okayjustin/ee541/Software/sar_image.png

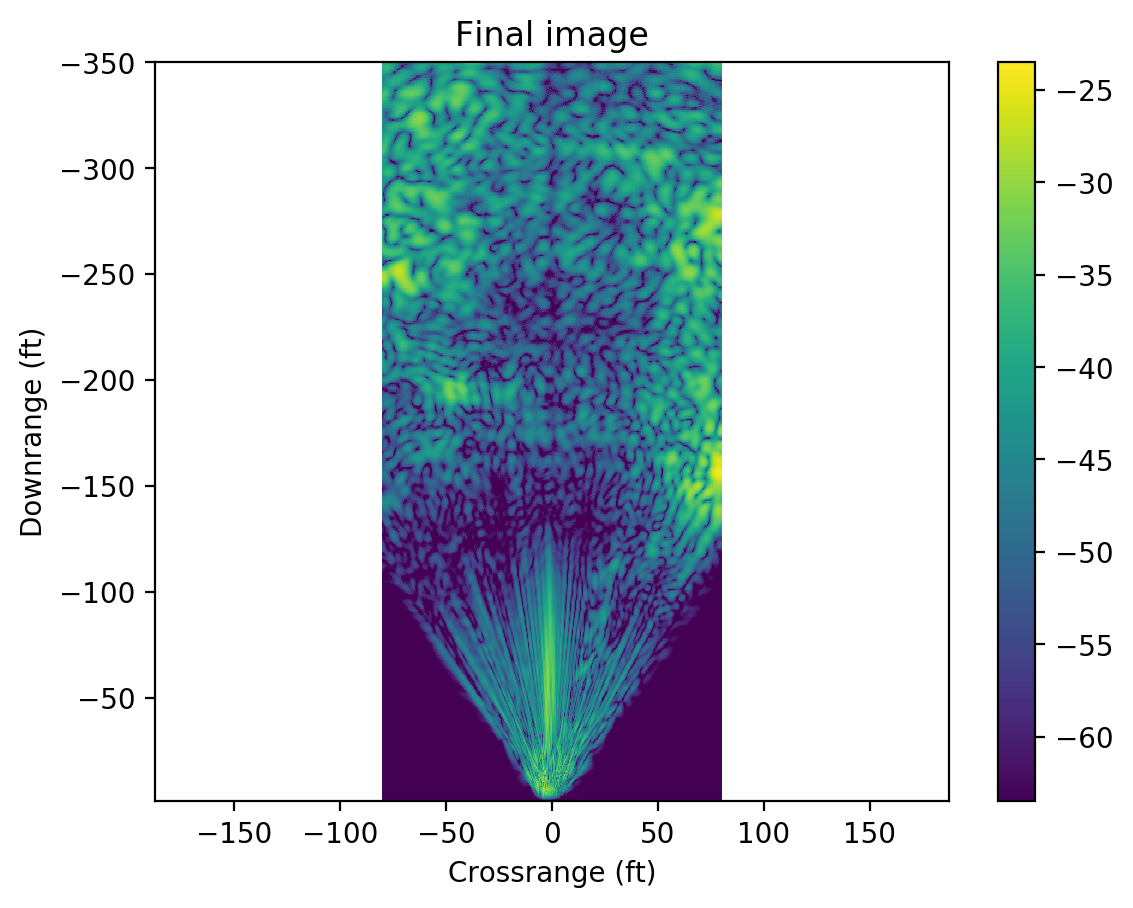
Software/sar_image.png
