okayjustin/ee541/Mechanical/assem.SLDASM

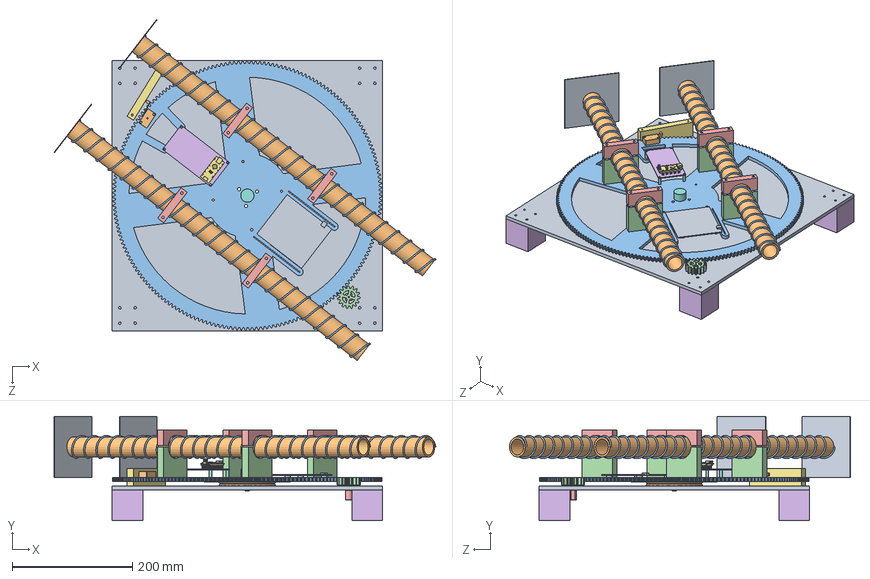
[picture p2: CAD file, 2017-03-17]
Mechanical/assem.SLDASM
635.3 x 173.2 x 567.3 mm
base_board
turntable
motor_shaft
pinion
motor_body
leg x 4
switch_trig_block
slipring
copper clad board x 2
pvc x 2
spiral coil x 2
antenna_holder_bottom x 4
antenna_holder_top x 4
PCB
Arduino Nano
nylon spacer x 4
vco_board
microswitch
table_gear_smaller
