okayjustin/ee541/Mechanical/table_assem.SLDASM

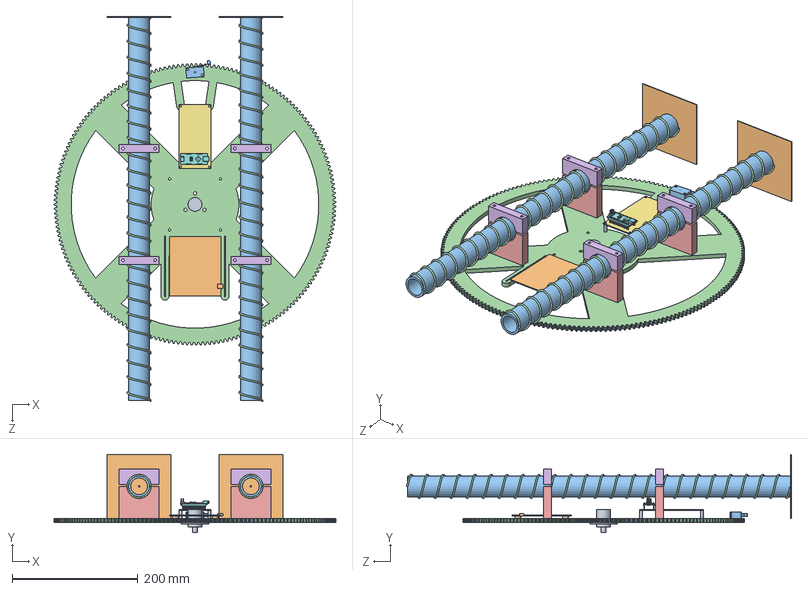
[picture p3: CAD file, 2017-03-17]
Mechanical/table_assem.SLDASM
447.9 x 124.3 x 612.2 mm
slipring
copper clad board x 2
pvc x 2
spiral coil x 2
antenna_holder_bottom x 4
antenna_holder_top x 4
PCB
Arduino Nano
nylon spacer x 4
vco_board
microswitch
table_gear_smaller
