okayjustin/ee541/Mechanical/antenna.SLDASM

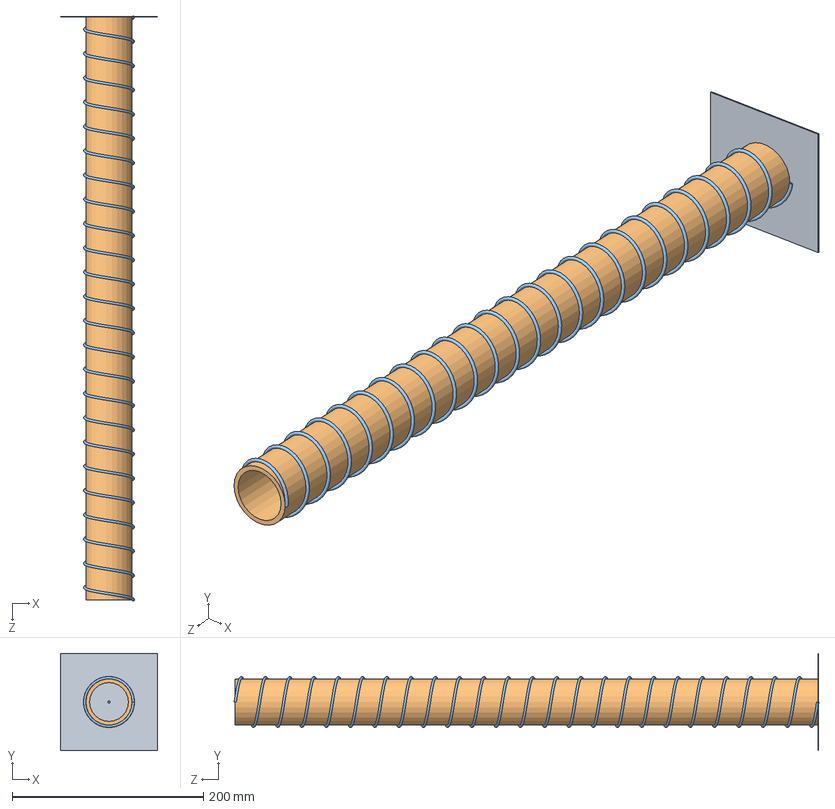
[picture p4: CAD file, 2017-03-11]
Mechanical/antenna.SLDASM
101.6 x 101.6 x 612.2 mm
copper clad board
pvc
spiral coil
