okayjustin/ee541/Mechanical/pinion_shaft_assem.SLDASM

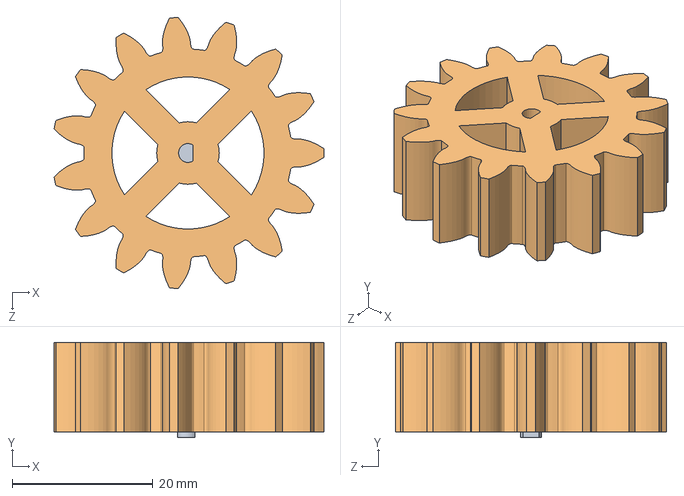
[picture p5: CAD file, 2017-03-11]
Mechanical/pinion_shaft_assem.SLDASM
38.3 x 13.5 x 38.6 mm
motor_shaft
pinion
