okayjustin/ee541/Mechanical/geartest.SLDASM

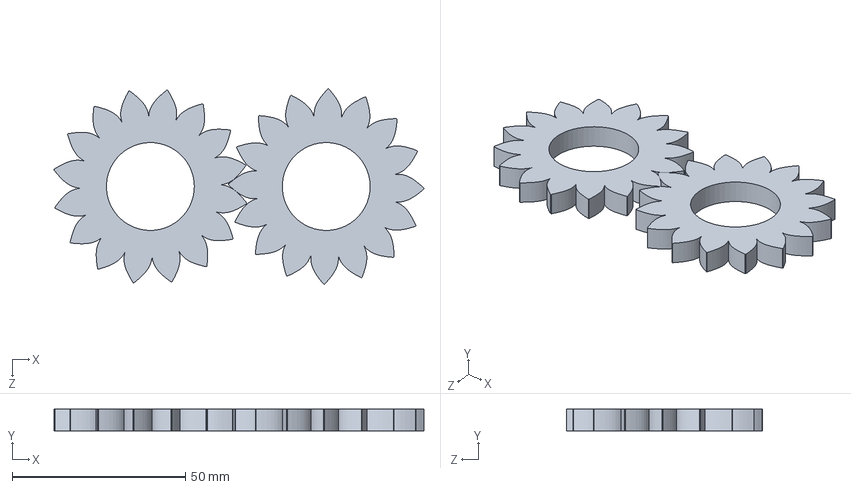
[picture p6: CAD file, 2017-02-28]
Mechanical/geartest.SLDASM
106.9 x 6.35 x 56.5 mm
spur_gear x 2
