okayjustin/ee541/Mechanical/table_gear.SLDPRT

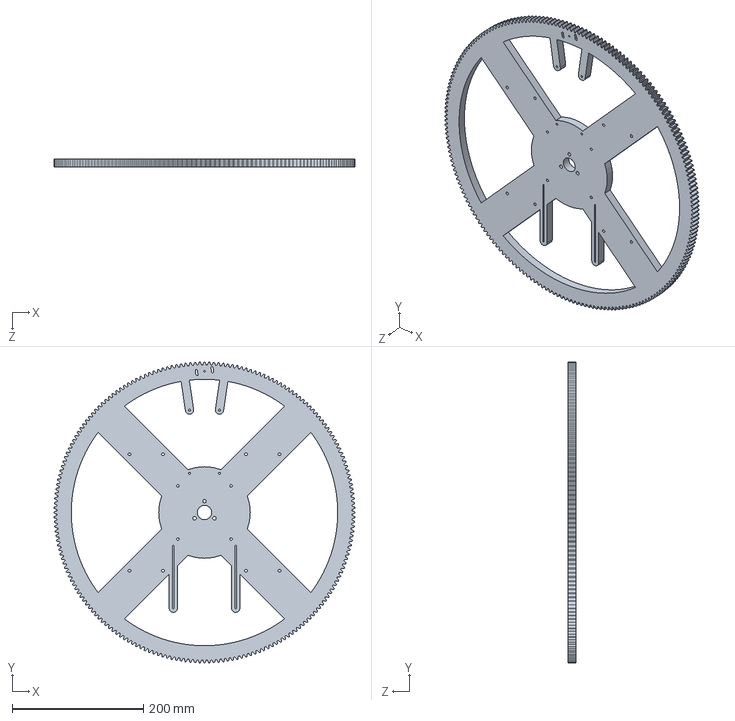
[picture p7: CAD file, 2017-03-17]
Mechanical/table_gear.SLDPRT
459.3 x 459.3 x 12.7 mm
