okayjustin/ee541/Mechanical/base_board.SLDPRT

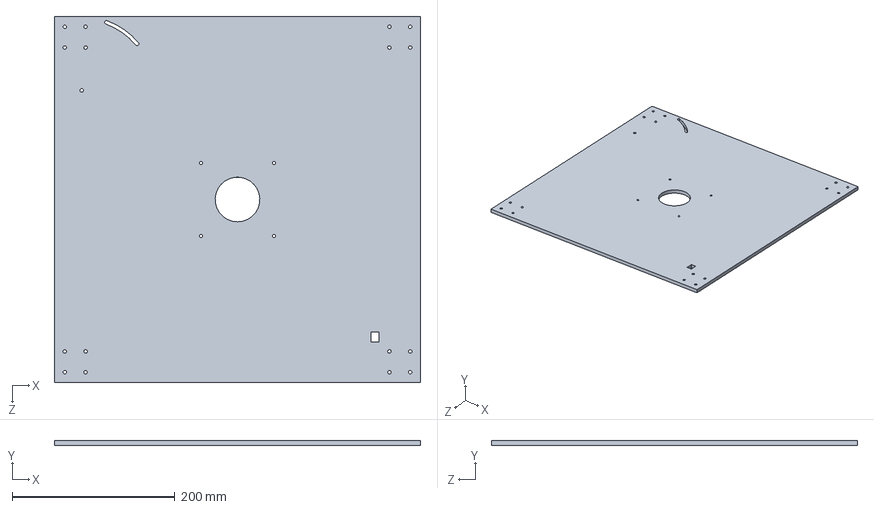
[picture p8: CAD file, 2017-03-17]
Mechanical/base_board.SLDPRT
449.6 x 6.35 x 449.6 mm
