okayjustin/ee541/Mechanical/spiral coil.SLDPRT

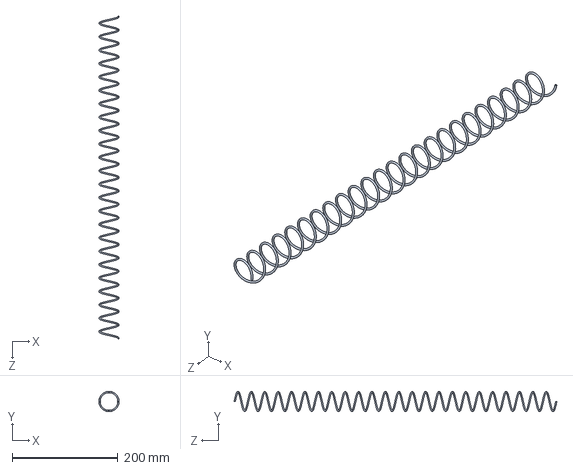
[picture p9: CAD file, 2017-03-11]
Mechanical/spiral coil.SLDPRT
38.6 x 38.6 x 612.2 mm
