okayjustin/ee541/Mechanical/copper clad board.SLDPRT

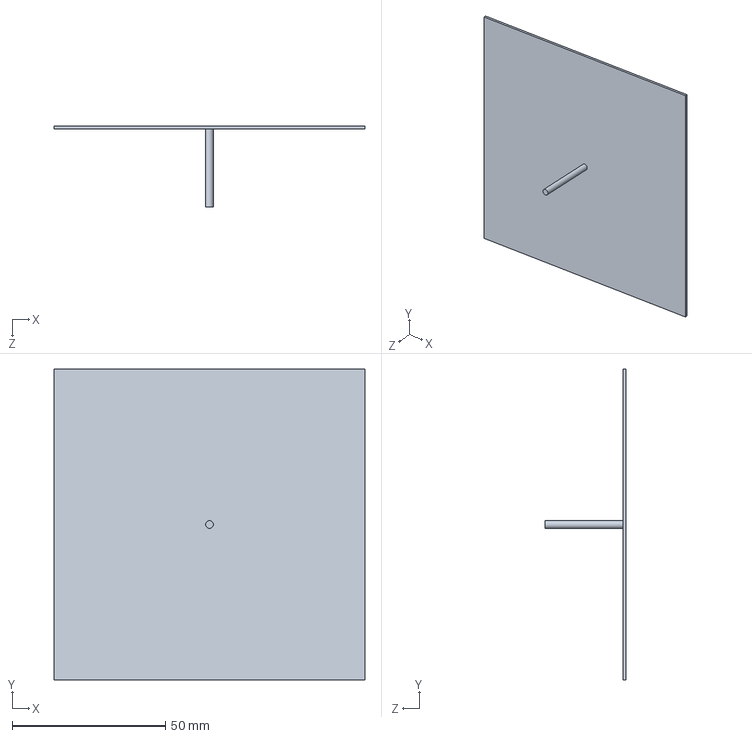
[picture p10: CAD file, 2017-03-11]
Mechanical/copper clad board.SLDPRT
101.6 x 101.6 x 26.4 mm
