okayjustin/ee541/Mechanical/pvc.SLDPRT

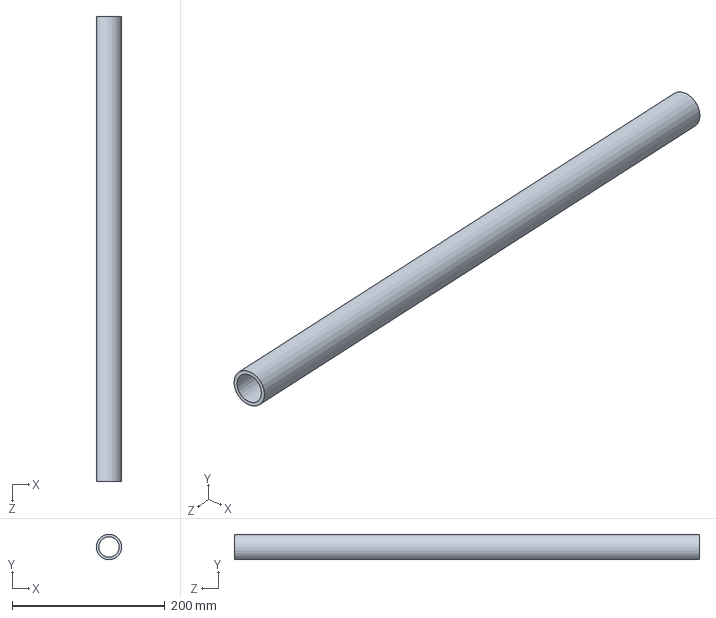
[picture p11: CAD file, 2017-03-11]
Mechanical/pvc.SLDPRT
33.4 x 33.4 x 609.6 mm
