okayjustin/ee541/Mechanical/switch_trig_block.SLDPRT

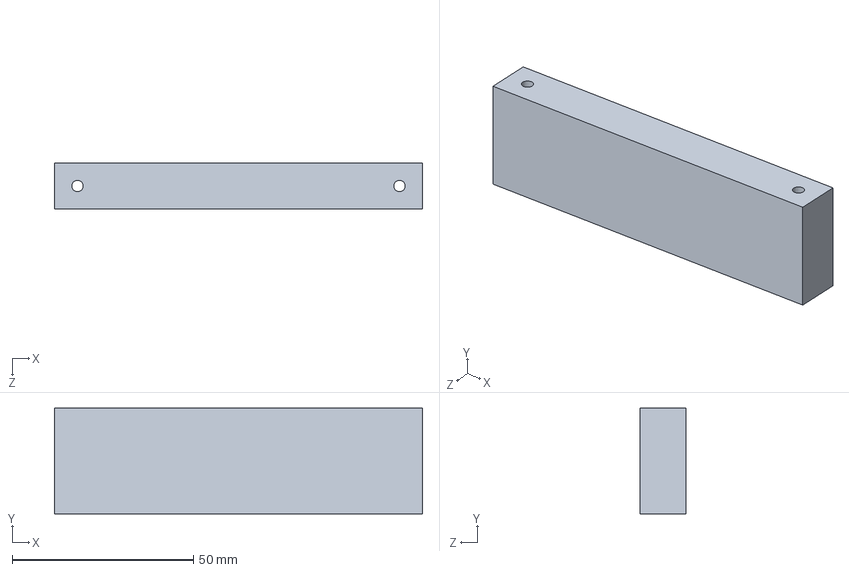
[picture p12: CAD file, 2017-03-11]
Mechanical/switch_trig_block.SLDPRT
101.6 x 29.2 x 12.7 mm
