okayjustin/ee541/Mechanical/nylon spacer.SLDPRT

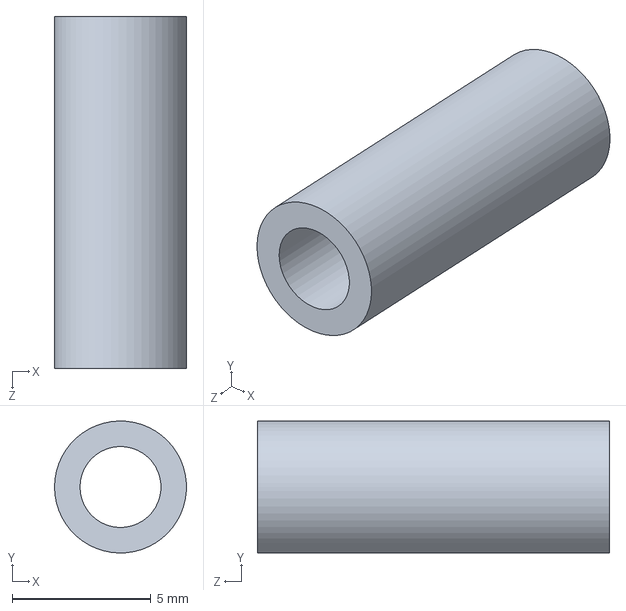
[picture p13: CAD file, 2017-03-11]
Mechanical/nylon spacer.SLDPRT
4.76 x 4.76 x 12.7 mm
