okayjustin/ee541/Mechanical/PCB.SLDPRT

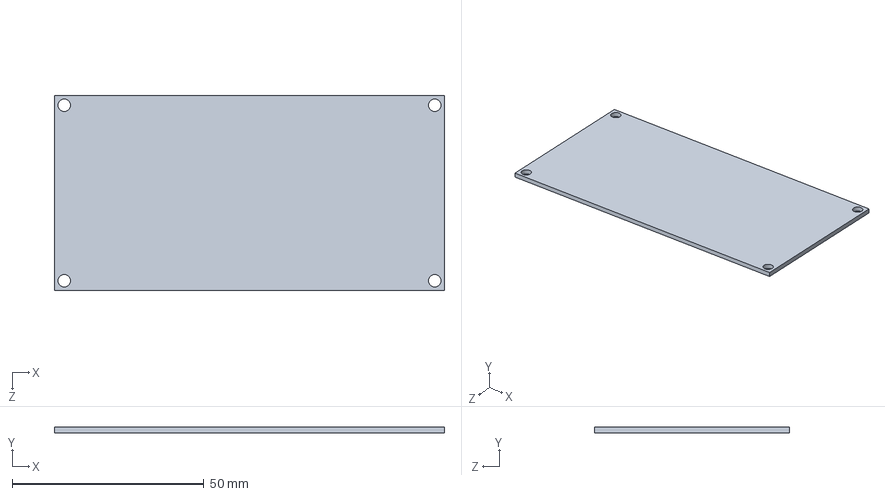
[picture p14: CAD file, 2017-03-11]
Mechanical/PCB.SLDPRT
101.6 x 1.45 x 50.8 mm
