okayjustin/ee541/Mechanical/vco_board.SLDPRT

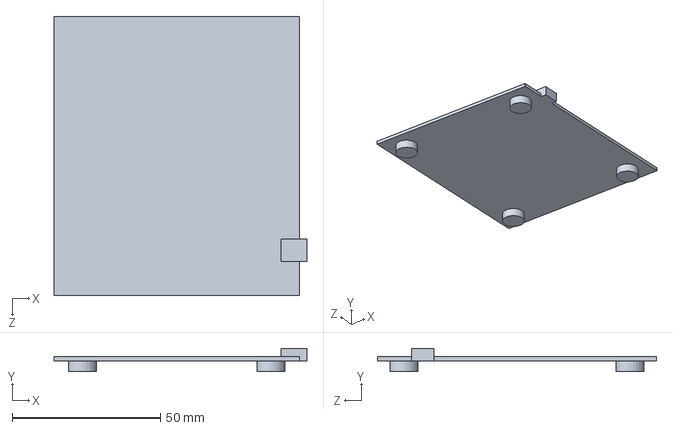
[picture p15: CAD file, 2017-03-11]
Mechanical/vco_board.SLDPRT
85.1 x 7.80 x 94.0 mm
