okayjustin/ee541/Mechanical/Arduino Nano.SLDPRT

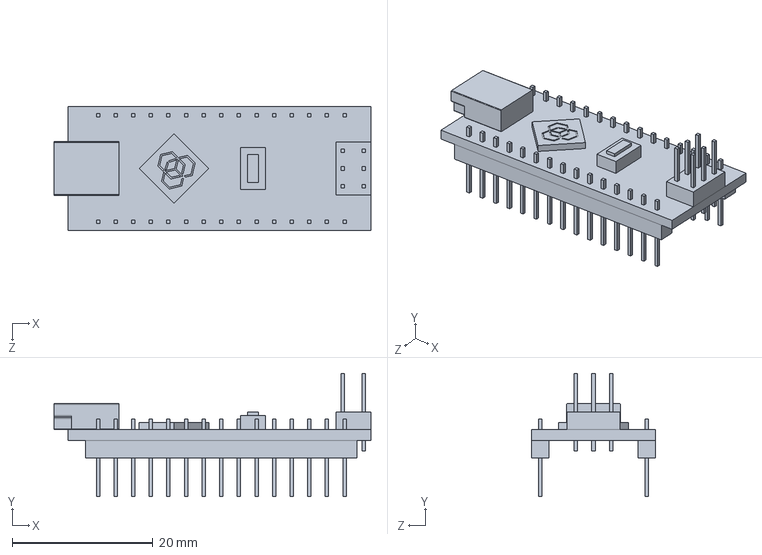
[picture p16: CAD file, 2017-03-11]
Mechanical/Arduino Nano.SLDPRT
45.0 x 17.5 x 17.6 mm
