okayjustin/ee541/Mechanical/microswitch.SLDPRT

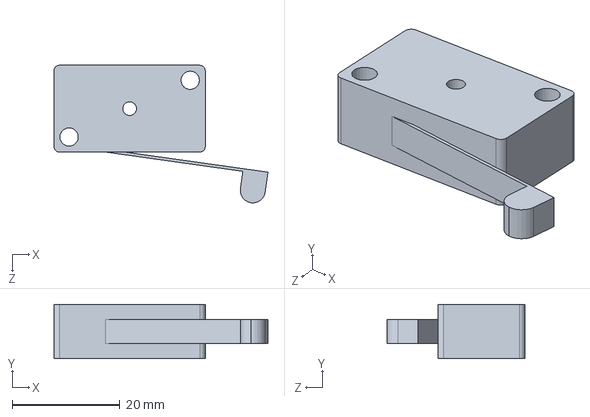
[picture p17: CAD file, 2017-03-11]
Mechanical/microswitch.SLDPRT
39.7 x 10.0 x 25.5 mm
