okayjustin/ee541/Mechanical/leg.SLDPRT

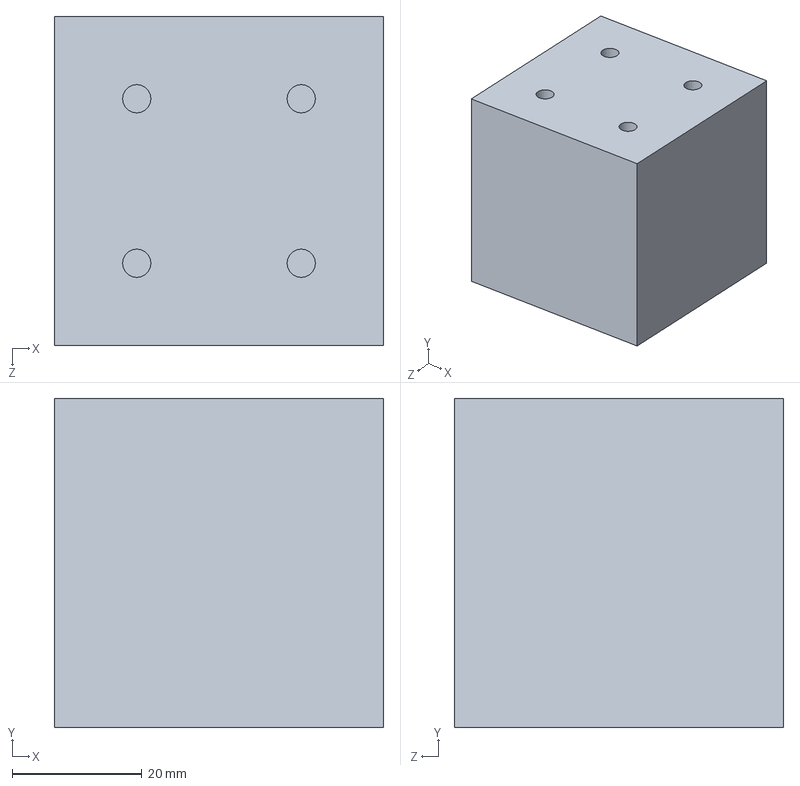
[picture p18: CAD file, 2017-03-11]
Mechanical/leg.SLDPRT
50.8 x 50.8 x 50.8 mm
