okayjustin/ee541/Mechanical/table.SLDPRT

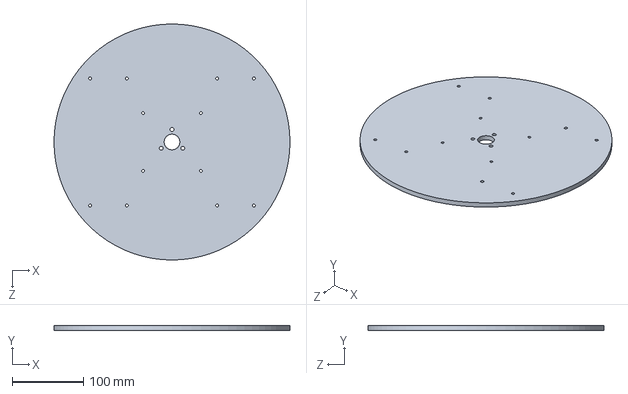
[picture p19: CAD file, 2017-03-11]
Mechanical/table.SLDPRT
330.2 x 6.35 x 330.2 mm
