okayjustin/ee541/Mechanical/motor_body.SLDPRT

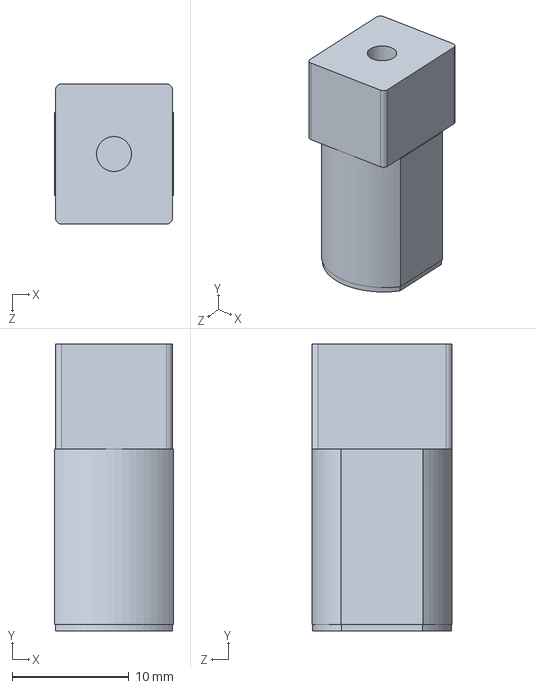
[picture p20: CAD file, 2017-03-11]
Mechanical/motor_body.SLDPRT
10.2 x 24.6 x 12.0 mm
