okayjustin/ee541/Mechanical/motor_shaft.SLDPRT

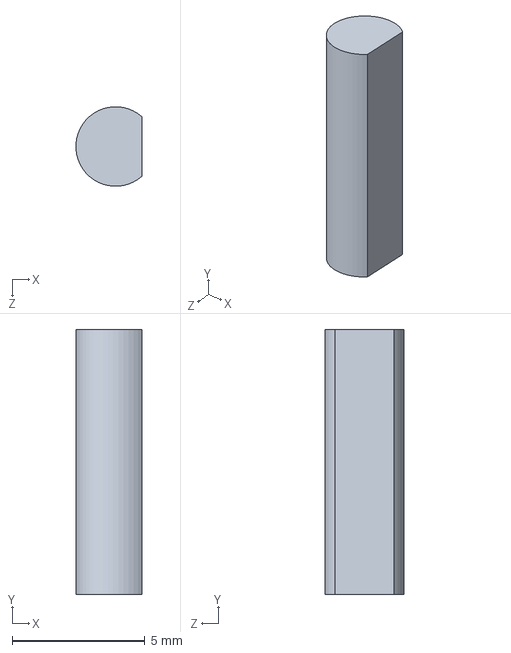
[picture p21: CAD file, 2017-03-11]
Mechanical/motor_shaft.SLDPRT
2.50 x 10.0 x 2.99 mm
