okayjustin/ee541/Mechanical/pinion.SLDPRT

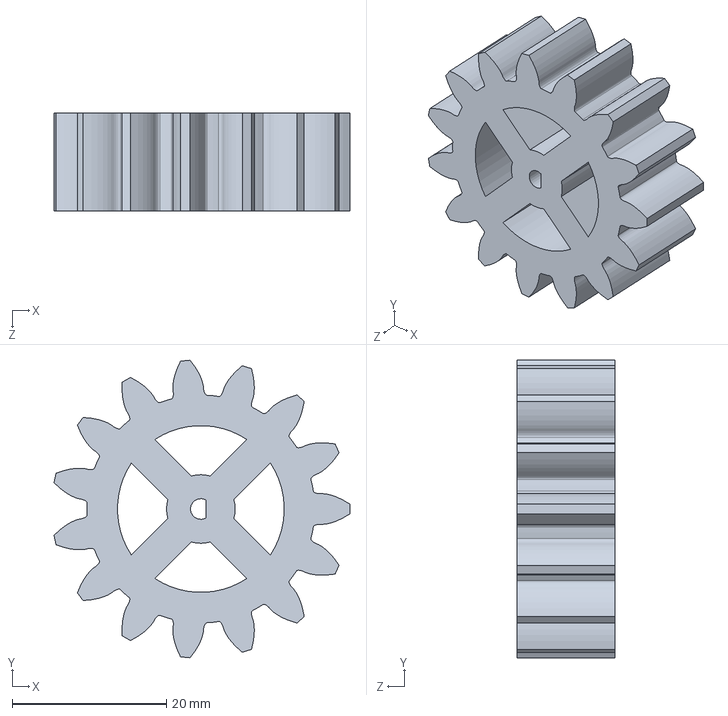
[picture p22: CAD file, 2017-03-11]
Mechanical/pinion.SLDPRT
38.3 x 38.6 x 12.7 mm
