okayjustin/ee541/Mechanical/antenna_holder_bottom.SLDPRT

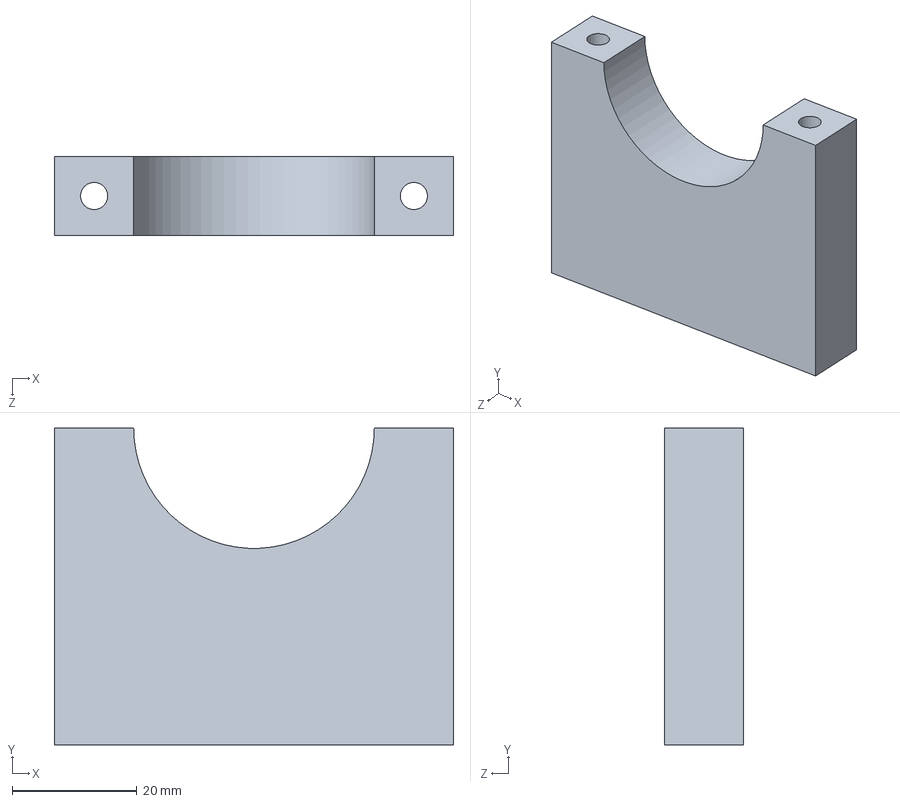
[picture p23: CAD file, 2017-03-11]
Mechanical/antenna_holder_bottom.SLDPRT
64.0 x 50.8 x 12.7 mm
