okayjustin/ee541/Mechanical/antenna_holder_top.SLDPRT

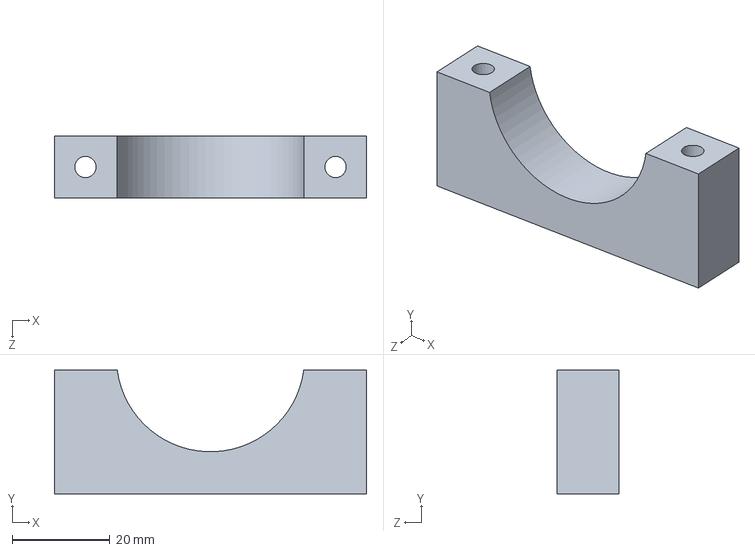
[picture p24: CAD file, 2017-03-11]
Mechanical/antenna_holder_top.SLDPRT
64.0 x 25.4 x 12.7 mm
