okayjustin/ee541/Mechanical/spur_gear.SLDPRT

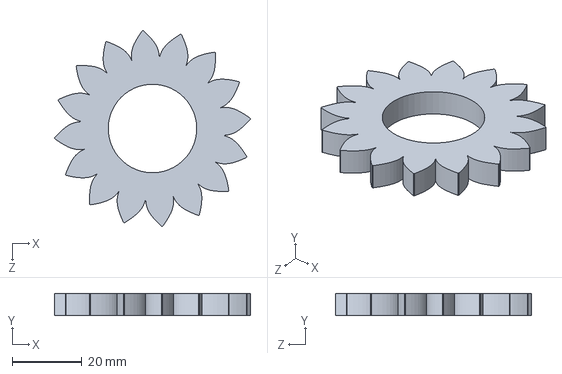
[picture p25: CAD file, 2017-02-28]
Mechanical/spur_gear.SLDPRT
56.3 x 6.35 x 56.3 mm
