okayjustin/ee541/Mechanical/turntable.SLDPRT

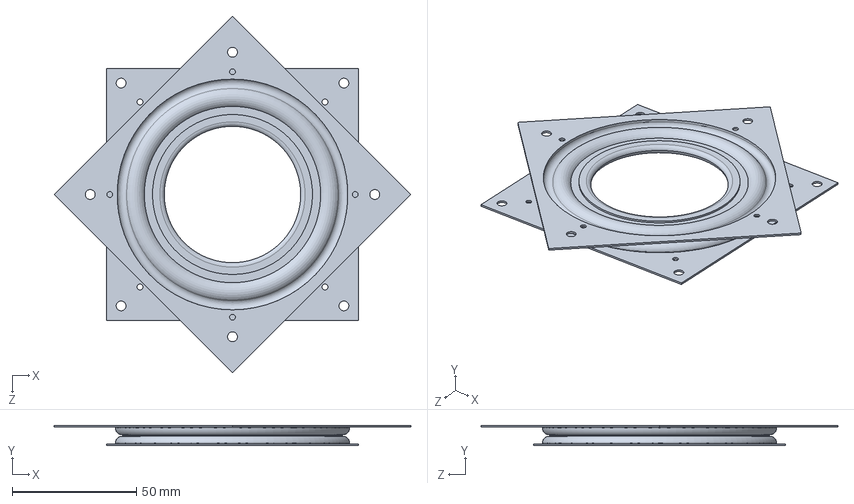
[picture p26: CAD file, 2017-02-28]
Mechanical/turntable.SLDPRT
143.7 x 8.13 x 143.7 mm
