okayjustin/ee541/Mechanical/slipring.SLDPRT

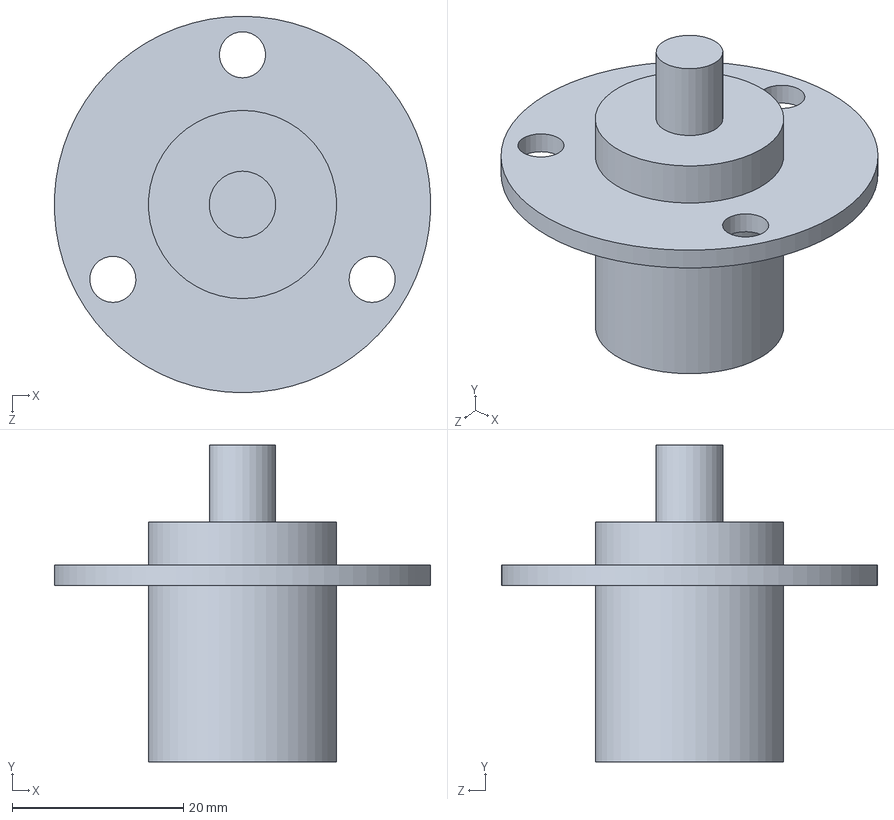
[picture p27: CAD file, 2017-02-28]
Mechanical/slipring.SLDPRT
44.0 x 37.0 x 44.0 mm
