okayjustin/ee541/(list of files, cad)

Other CAD files:
Mechanical/.5in wood 2.SLDDRW
Mechanical/5in wood 2.SLDDRW
Mechanical/base_board.SLDDRW
