okayjustin/ee541/Eagle/Radar/radar.brd

## EAGLE design Eagle/Radar/radar.brd (2017-02-20)

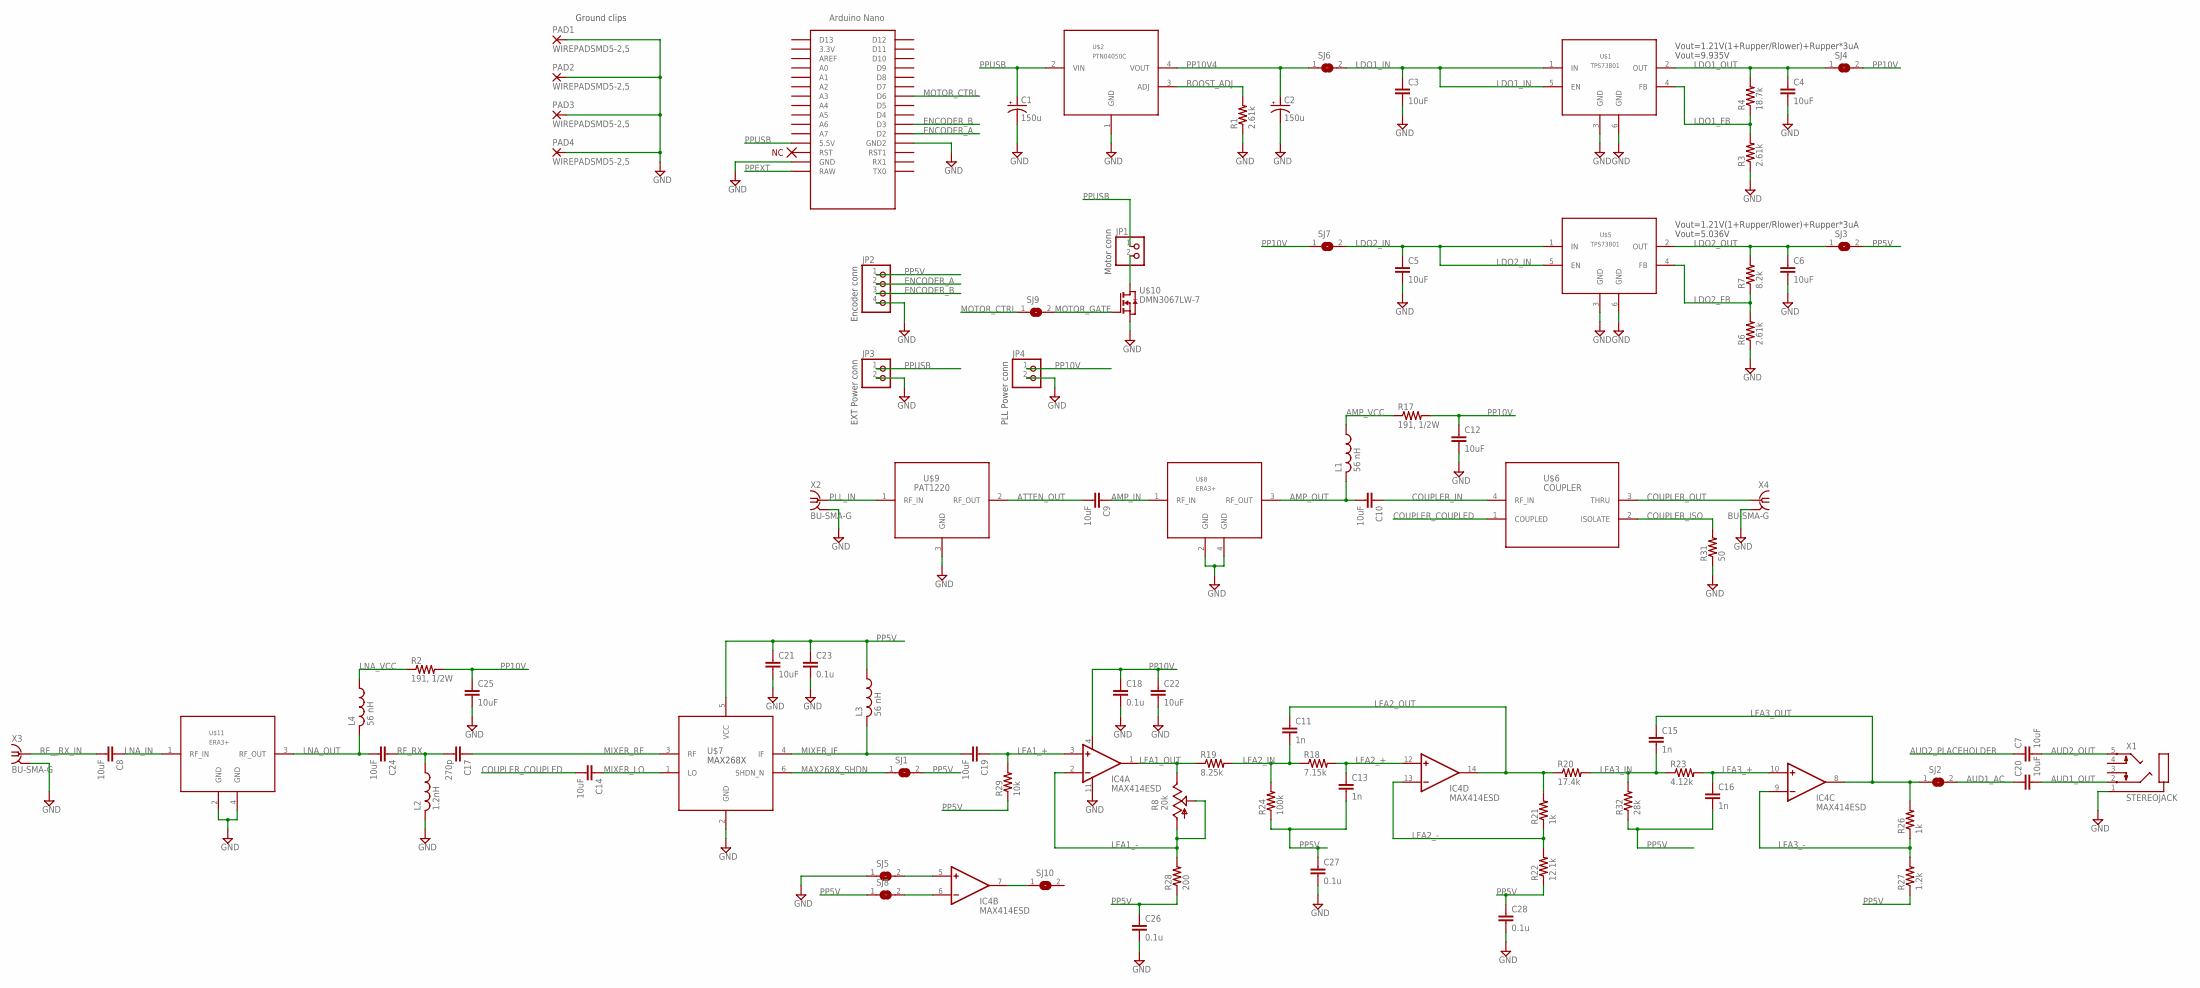
[picture p28: schematic radar.sch]

Parts:
C1, C2: 150u; 153CLV-0605; DIGI PCE4443CT-ND
C3, C4, C5, C6, C7, C8, C9, C10, C12, C14, C19, C20, C21, C22, C24, C25: 10uF; C0805K; DIGI 587-2985-1-ND
C11, C13, C15, C16: 1n; C0603; DIGI 311-1085-1-ND
C17: 270p; C0603K; DIGI 399-9054-1-ND
C18, C23, C26, C27, C28: 0.1u; C0603; DIGI 311-1088-1-ND
IC4: MAX414ESD; SO14; DIGI MAX414ESD+-ND
JP1, JP3, JP4: PINHD-1X2; 1X02
JP2: PINHD-1X4; 1X04
L1, L3, L4: 56 nH; 0603; DIGI 712-1443-1-ND
L2: 1.2nH; 0603; DIGI 535-11530-1-ND
PAD1, PAD2, PAD3, PAD4: WIREPADSMD5-2,5; 5-2,5
R1, R3, R6: 2.61k; R0603; DIGI 311-2520-1-ND
R2, R17: 191, 1/2W; R1210; DIGI P191AACT-ND
R4: 18.7k; R0603; DIGI 311-18.7KHRCT-ND
R7: 8.2k; R0603; DIGI 311-2680-1-ND
R8: 20k; B25P; DIGI 3362P-203LF-ND
R18: 7.15k; R0603; DIGI 311-7.15KHRCT-ND
R19: 8.25k; R0603; DIGI RNCP0805FTD8K25CT-ND
R20: 17.4k; R0603; DIGI 311-17.4KHRCT-ND
R21, R26: 1k; R0603; DIGI 311-1.00KHRCT-ND
R22: 12.1k; R0603; DIGI 541-12.1KSCT-ND
R23: 4.12k; R0603; DIGI 311-4.12KHRCT-ND
R24: 100k; R0603; DIGI 541-3247-1-ND
R27: 1.2k; R0603; DIGI 311-1.20KHRCT-ND
R28: 200; R0603; DIGI RNCP0805FTD200RCT-ND
R29: 10k; R0603; DIGI 311-10.0KHRCT-ND
R31: 50; R0603; DIGI RNCP0805FTD49R9CT-ND
R32: 28k; R0603; DIGI 311-28.0KHRCT-ND
SJ1, SJ2, SJ3, SJ4, SJ5, SJ6, SJ7, SJ8, SJ9, SJ10: SJ
U$1, U$5: TPS73801; SOT223-6
U$2: PTN04050C; DIGI 296-20498-ND
U$3: NANO
U$6: COUPLER
U$7: MAX268X; SOT23-6; DIGI MAX2682EUT+TCT-ND
U$8, U$11: ERA3+
U$9: PAT1220; DIGI PAT123CT-ND
U$10: DMN3067LW-7; SOT323; DIGI DMN3067LW-7DICT-ND
X1: STEREOJACK; STX3100; DIGI CP1-3555NG-ND
X2, X3, X4: BU-SMA-G; DIGI ACX2074-ND

Connections:
AMP_IN: C9.1, U$8.1 (RF_IN)
AMP_OUT: C10.2, L1.2, U$8.3 (RF_OUT)
AMP_VCC: L1.1, R17.1
ATTEN_OUT: C9.2, U$9.2 (RF_OUT)
AUD1_AC: C20.1, SJ2.2
AUD1_OUT: C20.2, X1.2
AUD2_OUT: C7.2, X1.5
AUD2_PLACEHOLDER: C7.1
BOOST_ADJ: R1.2, U$2.3 (ADJ)
COUPLER_COUPLED: C14.2, U$6.1 (COUPLED)
COUPLER_IN: C10.1, U$6.4 (RF_IN)
COUPLER_ISO: R31.2, U$6.2 (ISOLATE)
COUPLER_OUT: U$6.3 (THRU), X4.1
ENCODER_A: JP2.2, U$3.D2
ENCODER_B: JP2.3, U$3.D3
GND: C1.-, C2.-, C3.2, C4.2, C5.2, C6.2, C12.2, C18.2, C21.2, C22.2, C23.2, C25.2, C26.2, C27.2, C28.2, IC4.11 (V-), JP2.4, JP3.2, JP4.2, L2.2, PAD1.1, PAD2.1, PAD3.1, PAD4.1, R1.1, R3.1, R6.1, R31.1, SJ5.1, U$1.3 (GND), U$1.6 (GND), U$2.1 (GND), U$3.GND, U$3.GND1 (GND2), U$5.3 (GND), U$5.6 (GND), U$7.2 (GND), U$8.2 (GND), U$8.4 (GND), U$9.3 (GND), U$10.2 (S), U$11.2 (GND), U$11.4 (GND), X1.1, X2.2, X2.3 (2), X2.4 (2), X2.5 (2), X3.2, X3.3 (2), X3.4 (2), X3.5 (2), X4.2, X4.3 (2), X4.4 (2), X4.5 (2)
LDO1_FB: R3.2, R4.1, U$1.4 (FB)
LDO1_IN: C3.1, SJ6.2, U$1.1 (IN), U$1.5 (EN)
LDO1_OUT: C4.1, R4.2, SJ4.1, U$1.2 (OUT)
LDO2_FB: R6.2, R7.1, U$5.4 (FB)
LDO2_IN: C5.1, SJ7.2, U$5.1 (IN), U$5.5 (EN)
LDO2_OUT: C6.1, R7.2, SJ3.1, U$5.2 (OUT)
LFA1_+: C19.1, IC4.3 (+IN), R29.2
LFA1_-: IC4.2 (-IN), R8.A, R8.S, R28.2
LFA1_OUT: IC4.1 (OUT), R8.E, R19.1
LFA2_+: C13.1, IC4.12 (+IN), R18.2
LFA2_-: IC4.13 (-IN), R21.1, R22.2
LFA2_IN: C11.2, R18.1, R19.2, R24.2
LFA2_OUT: C11.1, IC4.14 (OUT), R20.1, R21.2
LFA3_+: C16.1, IC4.10 (+IN), R23.2
LFA3_-: IC4.9 (-IN), R26.1, R27.2
LFA3_IN: C15.2, R20.2, R23.1, R32.2
LFA3_OUT: C15.1, IC4.8 (OUT), R26.2, SJ2.1
LNA_IN: C8.1, U$11.1 (RF_IN)
LNA_OUT: C24.2, L4.2, U$11.3 (RF_OUT)
LNA_VCC: L4.1, R2.1
MAX268X_SHDN: SJ1.1, U$7.6 (SHDN_N)
MIXER_IF: C19.2, L3.2, U$7.4 (IF)
MIXER_LO: C14.1, U$7.1 (LO)
MIXER_RF: C17.1, U$7.3 (RF)
MOTOR_CTRL: SJ9.1, U$3.D6
MOTOR_GATE: SJ9.2, U$10.1 (G)
unnamed: JP1.2, U$10.3 (D)
unnamed: IC4.7 (OUT), SJ10.1
unnamed: IC4.5 (+IN), SJ5.2
unnamed: IC4.6 (-IN), SJ8.2
PLL_IN: U$9.1 (RF_IN), X2.1
PP5V: C13.2, C16.2, C21.1, C23.1, C26.1, C27.1, C28.1, JP2.1, L3.1, R22.1, R24.1, R27.1, R28.1, R29.1, R32.1, SJ1.2, SJ3.2, SJ8.1, U$7.5 (VCC)
PP10V: C12.1, C18.1, C22.1, C25.1, IC4.4 (V+), JP4.1, R2.2, R17.2, SJ4.2, SJ7.1
PP10V4: C2.+, SJ6.1, U$2.4 (VOUT)
PPEXT: U$3.RAW
PPUSB: C1.+, JP1.1, JP3.1, U$2.2 (VIN), U$3.5V (5.5V)
RF_RX: C17.2, C24.1, L2.1
RF__RX_IN: C8.2, X3.1

Notes on the sheet:
Vout=1.21V(1+Rupper/Rlower)+Rupper*3uA
Vout=9.935V
Vout=5.036V
Ground clips
Encoder conn
Motor conn
EXT Power conn
PLL Power conn

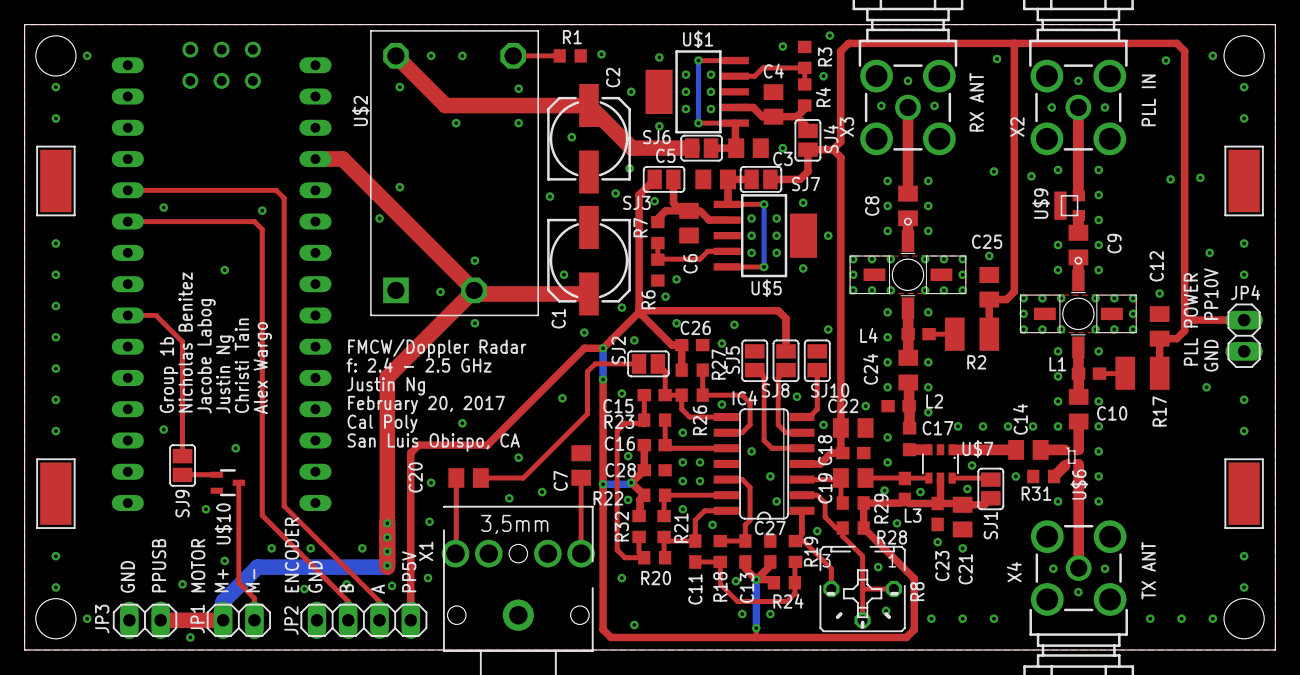
[picture p29: board radar.brd from above]

Board: 2 copper layers, 101.6 x 50.8 mm, 86 parts (0 on the bottom side), 52 nets.
