okayjustin/ee541/(commit log)

2017-01-24 Updated some print() functions for python3 compatibility. Removed some log10 functions temporarily
2017-02-16 Finished power section schematic. Started board
    [radar.brd, radar.sch]
2017-02-16 Added amplifier circuits, ground clips, 3.5mm
    [radar.brd, radar.sch]
2017-02-17 Updated schematic
    [radar.brd, radar.sch]
2017-02-17 Updated digi values
    [radar.brd, radar.sch]
2017-02-18 Finalized sch
    [radar.brd, radar.sch]
2017-02-18 Moved some board parts
    [radar.brd]
2017-02-19 Nearly completed placements on board
    [radar.brd, radar.sch]
2017-02-19 Finished RF routing
    [radar.brd, radar.sch]
2017-02-20 Routing complete
    [radar.brd, radar.sch]
2017-02-20 Routes complete, no drc errors, no erc errors, need silks
    [radar.brd, radar.sch]
2017-02-20 Started silks, gnd stitch complete
    [radar.brd]
2017-02-20 Design complete
    [radar.brd, radar.sch]
2017-02-22 Created radar model
    [antenna.SLDASM, assem.SLDASM, base_board.SLDPRT, copper clad board.SLDPRT, pvc.SLDPRT, slipring.SLDPRT, spiral coil.SLDPRT, table.SLDPRT]
2017-02-28 found slightly modified make_sar_image.py in order to create a SAR image file because cantenna_sar.py is not working on python 2.7
    [cantenna_sar.py, generate_SineWav.py, generate_Wav.py, make_sar_image.py]
2017-02-28 Added gear
    [antenna.SLDASM, assem.SLDASM, base_board.SLDPRT, geartest.SLDASM, pvc.SLDPRT, spiral coil.SLDPRT, spur_gear.SLDPRT]
2017-03-11 Added a bunch of solidworks models
    [antenna_holder_bottom.SLDPRT, antenna_holder_top.SLDPRT, assem.SLDASM, base_board.SLDPRT, motor_body.SLDPRT, motor_shaft.SLDPRT, pinion.SLDPRT, pinion_shaft_assem.SLDASM]
2017-03-11 Nearly completed modeling. Needs switch triggering block
    [102 RESISTOR PACK.SLDPRT, 15pin_header__.sldprt, 16mhz crystal - measured.SLDPRT, 189 RESISTOR PACK.SLDPRT, 2pin_header__02.sldprt, Arduino Nano.SLDPRT, MINI USB CONTACT.SLDPRT, MINI USB SOLDER.SLDPRT]
2017-03-11 Design complete. Need to generate illustrator files
    [102 RESISTOR PACK.SLDPRT, 15pin_header__.sldprt, 16mhz crystal - measured.SLDPRT, 189 RESISTOR PACK.SLDPRT, 2pin_header__02.sldprt, MINI USB CONTACT.SLDPRT, MINI USB SOLDER.SLDPRT, MINIUSB - MEASURED.SLDASM]
2017-03-12 Added illustrator drawings
    [.5in wood 2.SLDDRW, assem.SLDASM, base_board.SLDDRW, base_board.SLDPRT, table_assem.SLDASM, table_gear.SLDPRT]
2017-03-14 Fixed naming for some files
    [5in wood 2.SLDDRW]
2017-03-17 Added smaller table gear
    [assem.SLDASM, base_board.SLDPRT, table_assem.SLDASM, table_gear.SLDPRT]
2017-03-17 base board
